shawaizhaider/kairos/demo/mandelbrotset.jpeg

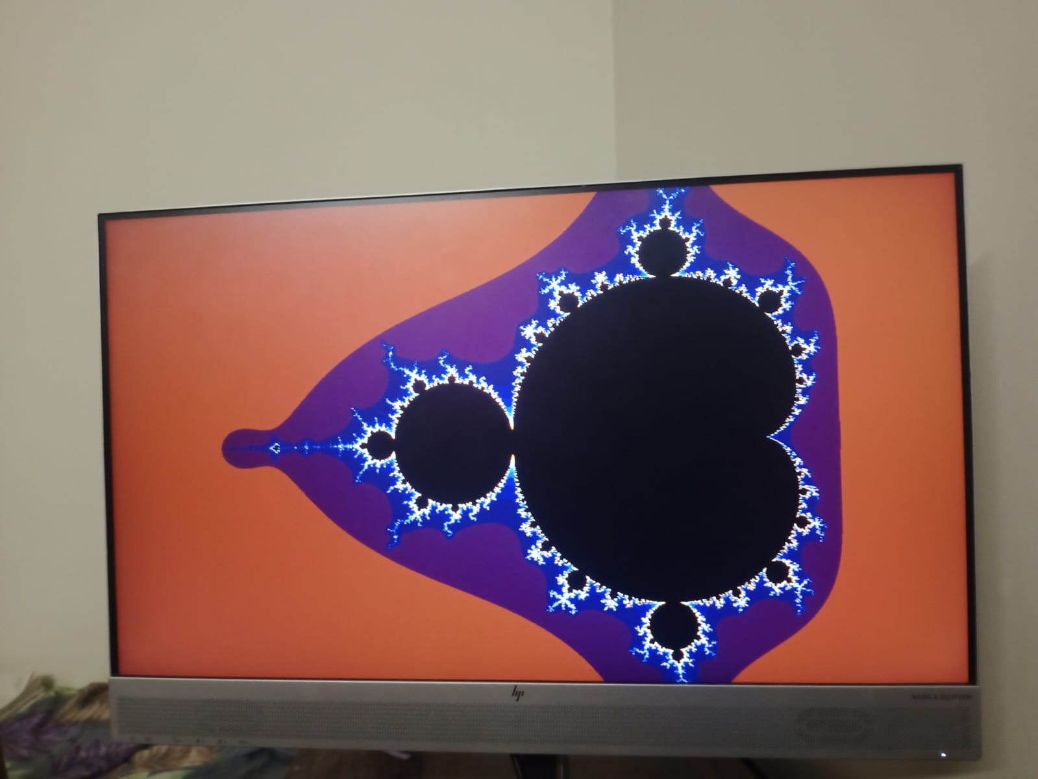
demo/mandelbrotset.jpeg
