shawaizhaider/kairos/block_design/block-design.pdf

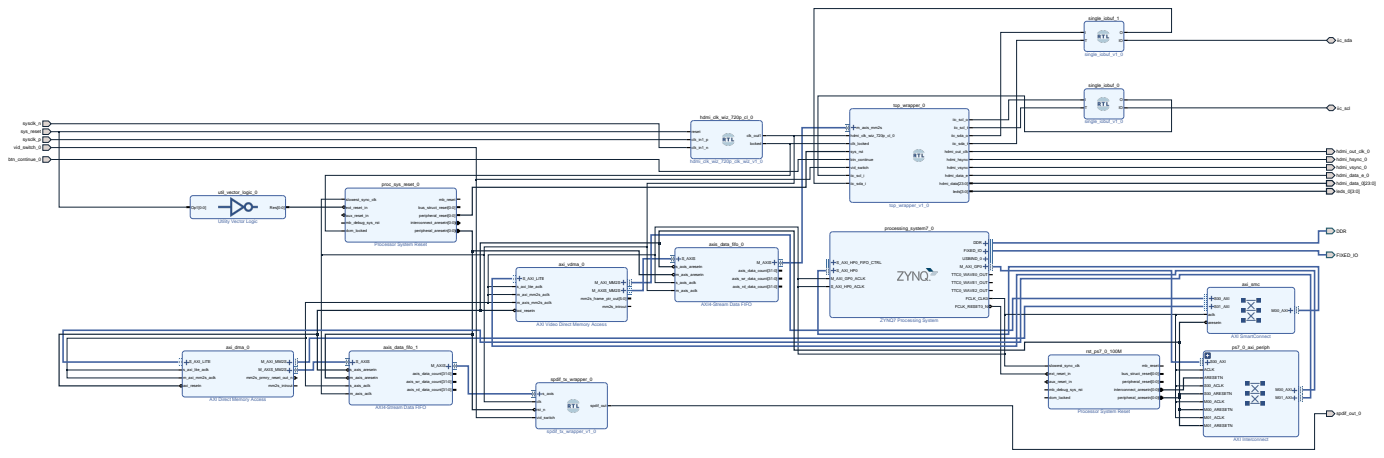
[picture p14: page 1]
DDR; FIXED_IO; axi_dma_0; S_AXI_LITE; M_AXI_MM2S; s_axi_lite_aclk; M_AXIS_MM2S m_axi_mm2s_aclk axi_resetn; mm2s_prmry_reset_out_n mm2s_introut; axi_smc; AXI SmartConnect; S00_AXI S01_AXI; M00_AXI aclk aresetn; axi_vdma_0; M_AXI_MM2S M_AXIS_MM2S; s_axi_lite_aclk m_axi_mm2s_aclk m_axis_mm2s_aclk axi_resetn; mm2s_frame_ptr_out[5:0] mm2s_introut; axis_data_fifo_0; S_AXIS; M_AXIS; s_axis_aresetn m_axis_aresetn; s_axis_aclk m_axis_aclk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

Utility Vector Logic

Processor System Reset

AXI4-Stream Data FIFO

AXI Video Direct Memory Access

AXI Direct Memory Access
