shawaizhaider/kairos/hdl/debouncer.sv

`timescale 1ns / 1ps
`default_nettype none

//written in lab!
//debounce_2.sv is a different attempt at this done after class with a few students
module  debouncer #(parameter CLK_PERIOD_NS = 13,
                    parameter DEBOUNCE_TIME_MS = 5
                    ) (   input wire clk_in,
                          input wire rst_in,
                          input wire dirty_in,
                          output logic clean_out);
  //you will likely need to cast this:
  localparam COUNTER_MAX = (DEBOUNCE_TIME_MS * 1_000_000 + CLK_PERIOD_NS - 1) / CLK_PERIOD_NS;
  localparam COUNTER_SIZE = $clog2(COUNTER_MAX);
  logic [COUNTER_SIZE-1:0] counter;
  logic current; //register holds current output
  logic old_dirty_in;
  assign clean_out = current;

  always_ff @(posedge clk_in)begin
    if (rst_in)begin
      counter <= 0;
      current <= dirty_in;
      old_dirty_in <= dirty_in;
    end else begin
      old_dirty_in <= dirty_in;
      if (counter == COUNTER_MAX-1)begin
        current <= old_dirty_in;
        counter <= 0;
      end else if (dirty_in == old_dirty_in) begin
        counter <= counter +1;
      end else begin
        counter <= 0;
      end
    end
  end
endmodule

`default_nettype wire
